reivax-boucoi/RecupNRJ/spec_functionnal.jpg

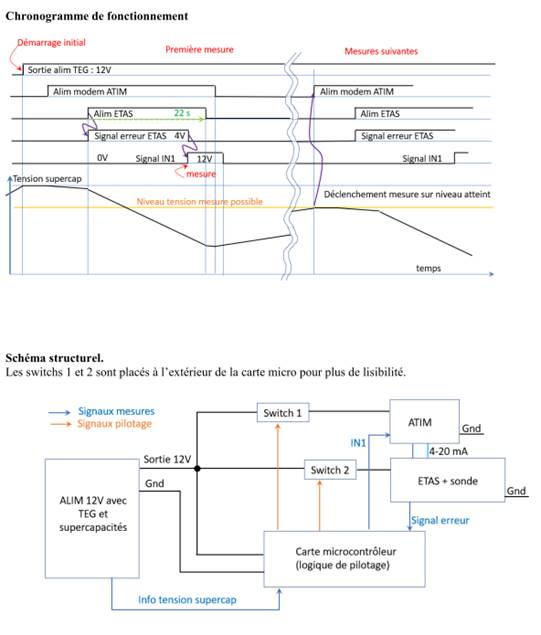
spec_functionnal.jpg
