reivax-boucoi/RecupNRJ/hardware/main.pdf

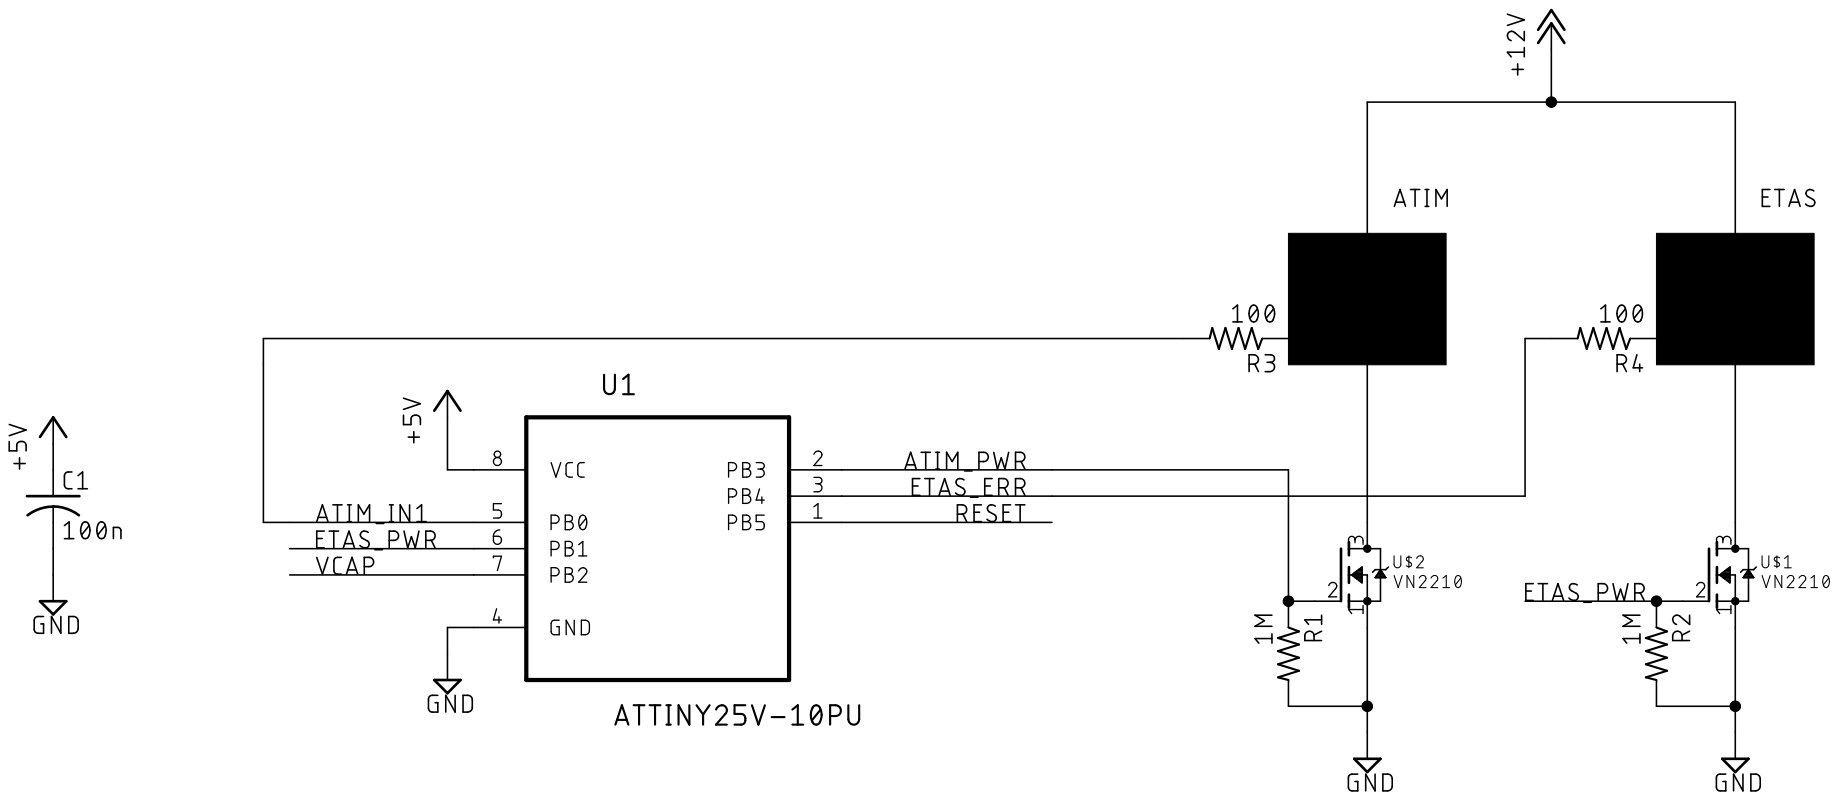
[picture p17: page 1]
