reivax-boucoi/RecupNRJ/hardware/main.sch

## EAGLE design hardware/main.sch (2020-12-23)

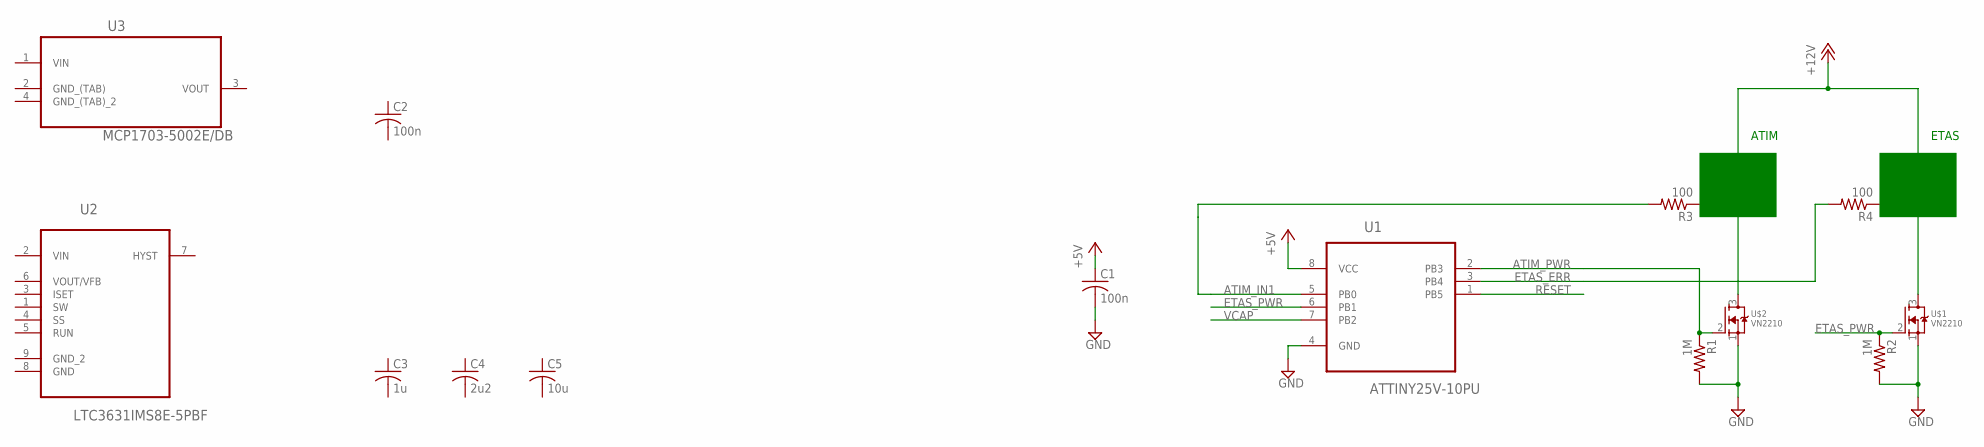
[picture p18: schematic main.sch]

Parts:
C1, C2: 100n; C0805
C3: 1u; C0805
C4: 2u2; C0805
C5: 10u; C0805
R1, R2: 1M; M0805
R3, R4: 100; M0805
U1: ATTINY25V-10PU; DIP254P762X533-8
U2: LTC3631IMS8E-5PBF; SOP65P490X110-9N
U3: MCP1703-5002E/DB; SOT230P700X180-4N
U$1, U$2: VN2210; TO92

Connections:
+5V: C1.1, U1.8 (VCC)
ATIM_IN1: R3.2, U1.5 (PB0)
ATIM_PWR: R1.1, U1.2 (PB3), U$2.2 (G)
ETAS_ERR: R4.2, U1.3 (PB4)
ETAS_PWR: R2.1, U1.6 (PB1), U$1.2 (G)
GND: C1.2, R1.2, R2.2, U1.4 (GND), U$1.1 (S), U$2.1 (S)
RESET: U1.1 (PB5)
VCAP: U1.7 (PB2)

Notes on the sheet:
ATIM
ETAS
